tdorssers/meArm/schematic/meArm.sch

## EAGLE design schematic/meArm.sch (2019-11-09)

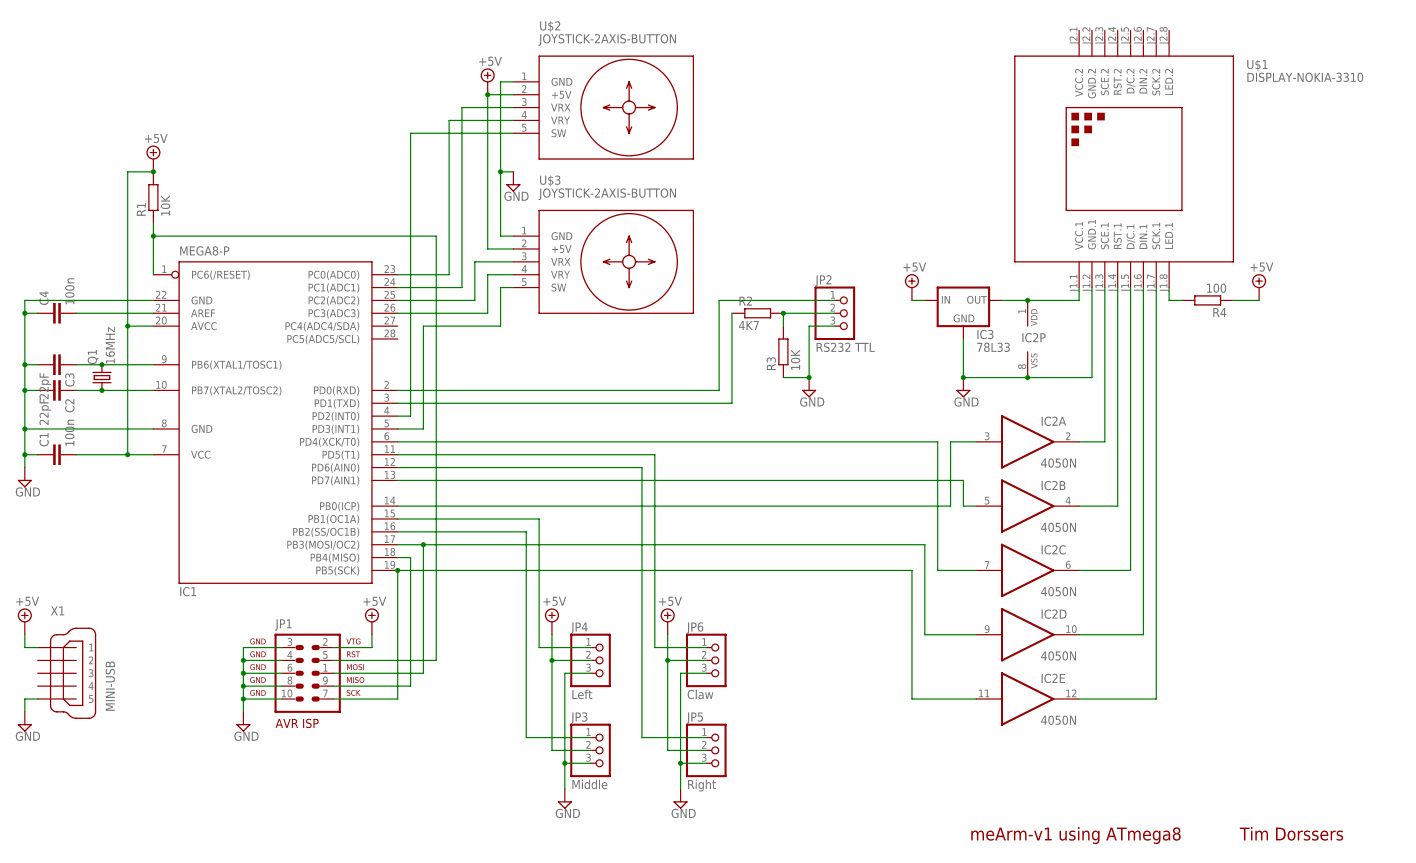
[picture p3: schematic meArm.sch]

Parts:
C1, C4: 100n; C025-025X050
C2, C3: 22pF; C025-024X044
IC1: MEGA8-P; DIL28-3
IC2: 4050N; DIL16
IC3: 78L33; 78LXX
JP1: AVR-ISP-10
JP2: RS232 TTL; 1X03
JP3: Middle; 1X03
JP4: Left; 1X03
JP5: Right; 1X03
JP6: Claw; 1X03
Q1: 16MHz; HC49U-V
R1, R3: 10K; 0204/7
R2: 4K7; 0204/7
R4: 100; 0204/7
U$1: DISPLAY-NOKIA-3310
U$2, U$3: JOYSTICK-2AXIS-BUTTON
X1: MINI-USB; 32005-601

Connections:
+5V: C1.2, IC1.7 (VCC), IC1.20 (AVCC), IC3.IN, JP1.2, JP3.2, JP4.2, JP5.2, JP6.2, R1.2, R4.1, U$2.2 (+5V), U$3.2 (+5V), X1.1
GND: C1.1, C2.2, C3.2, C4.1, IC1.8 (GND), IC1.22 (GND), IC2.8 (VSS), IC3.GND, JP1.3, JP1.4, JP1.6, JP1.8, JP1.10, JP2.3, JP3.3, JP4.3, JP5.3, JP6.3, R3.1, U$1.J1.2 (GND.1), U$2.1 (GND), U$3.1 (GND), X1.5
unnamed: IC1.19 (PB5(SCK)), IC2.11 (I), JP1.7
unnamed: IC2.1 (VDD), IC3.OUT, U$1.J1.1 (VCC.1)
unnamed: IC1.18 (PB4(MISO)), JP1.9
unnamed: IC1.17 (PB3(MOSI/OC2)), IC2.9 (I), JP1.1
unnamed: R4.2, U$1.J1.8 (LED.1)
unnamed: IC2.2 (O), U$1.J1.3 (SCE.1)
unnamed: IC2.4 (O), U$1.J1.4 (RST.1)
unnamed: IC2.6 (O), U$1.J1.5 (D/C.1)
unnamed: IC2.10 (O), U$1.J1.6 (DIN.1)
unnamed: IC2.12 (O), U$1.J1.7 (SCK.1)
unnamed: IC1.23 (PC0(ADC0)), U$2.4 (VRY)
unnamed: IC1.24 (PC1(ADC1)), U$2.3 (VRX)
unnamed: IC1.25 (PC2(ADC2)), U$3.3 (VRX)
unnamed: IC1.26 (PC3(ADC3)), U$3.4 (VRY)
unnamed: IC1.2 (PD0(RXD)), JP2.1
unnamed: IC1.3 (PD1(TXD)), R2.1
unnamed: IC1.4 (PD2(INT0)), U$2.5 (SW)
unnamed: IC1.5 (PD3(INT1)), U$3.5 (SW)
unnamed: IC1.1 (PC6(/RESET)), JP1.5, R1.1
unnamed: C3.1, IC1.9 (PB6(XTAL1/TOSC1)), Q1.2
unnamed: C2.1, IC1.10 (PB7(XTAL2/TOSC2)), Q1.1
unnamed: C4.2, IC1.21 (AREF)
unnamed: IC1.6 (PD4(XCK/T0)), IC2.7 (I)
unnamed: IC1.13 (PD7(AIN1)), IC2.5 (I)
unnamed: IC1.15 (PB1(OC1A)), JP4.1
unnamed: IC1.16 (PB2(SS/OC1B)), JP3.1
unnamed: IC1.14 (PB0(ICP)), IC2.3 (I)
unnamed: IC1.11 (PD5(T1)), JP6.1
unnamed: IC1.12 (PD6(AIN0)), JP5.1
unnamed: JP2.2, R2.2, R3.2

Notes on the sheet:
Tim Dorssers
meArm-v1 using ATmega8
