tdorssers/meArm/pcd8544.c

/*
 * pcd8544.c
 * 48x84 LCD Driver
 *
 * Created: 6-11-2019 18:05:15
 *  Author: Tim Dorssers
 *
 * Wiring:
 * PB2 -> SCE
 * PB3 -> DIN
 * PB5 -> CLK
 * PD4 -> D/C
 * PD7 -> RST
 */ 

#define F_CPU 16000000

#include <avr/io.h>
#include <util/delay.h>
#include <avr/pgmspace.h>
#include <string.h>

const uint8_t CHARSET[][5] PROGMEM = {
	{ 0x00, 0x00, 0x00, 0x00, 0x00 }, // 20 space
	{ 0x00, 0x00, 0x5f, 0x00, 0x00 }, // 21 !
	{ 0x00, 0x07, 0x00, 0x07, 0x00 }, // 22 "
	{ 0x14, 0x7f, 0x14, 0x7f, 0x14 }, // 23 #
	{ 0x24, 0x2a, 0x7f, 0x2a, 0x12 }, // 24 $
	{ 0x23, 0x13, 0x08, 0x64, 0x62 }, // 25 %
	{ 0x36, 0x49, 0x55, 0x22, 0x50 }, // 26 &
	{ 0x00, 0x05, 0x03, 0x00, 0x00 }, // 27 '
	{ 0x00, 0x1c, 0x22, 0x41, 0x00 }, // 28 (
	{ 0x00, 0x41, 0x22, 0x1c, 0x00 }, // 29 )
	{ 0x14, 0x08, 0x3e, 0x08, 0x14 }, // 2a *
	{ 0x08, 0x08, 0x3e, 0x08, 0x08 }, // 2b +
	{ 0x00, 0x50, 0x30, 0x00, 0x00 }, // 2c ,
	{ 0x08, 0x08, 0x08, 0x08, 0x08 }, // 2d -
	{ 0x00, 0x60, 0x60, 0x00, 0x00 }, // 2e .
	{ 0x20, 0x10, 0x08, 0x04, 0x02 }, // 2f /
	{ 0x3e, 0x51, 0x49, 0x45, 0x3e }, // 30 0
	{ 0x00, 0x42, 0x7f, 0x40, 0x00 }, // 31 1
	{ 0x42, 0x61, 0x51, 0x49, 0x46 }, // 32 2
	{ 0x21, 0x41, 0x45, 0x4b, 0x31 }, // 33 3
	{ 0x18, 0x14, 0x12, 0x7f, 0x10 }, // 34 4
	{ 0x27, 0x45, 0x45, 0x45, 0x39 }, // 35 5
	{ 0x3c, 0x4a, 0x49, 0x49, 0x30 }, // 36 6
	{ 0x01, 0x71, 0x09, 0x05, 0x03 }, // 37 7
	{ 0x36, 0x49, 0x49, 0x49, 0x36 }, // 38 8
	{ 0x06, 0x49, 0x49, 0x29, 0x1e }, // 39 9
	{ 0x00, 0x36, 0x36, 0x00, 0x00 }, // 3a :
	{ 0x00, 0x56, 0x36, 0x00, 0x00 }, // 3b ;
	{ 0x08, 0x14, 0x22, 0x41, 0x00 }, // 3c <
	{ 0x14, 0x14, 0x14, 0x14, 0x14 }, // 3d =
	{ 0x00, 0x41, 0x22, 0x14, 0x08 }, // 3e >
	{ 0x02, 0x01, 0x51, 0x09, 0x06 }, // 3f ?
	{ 0x32, 0x49, 0x79, 0x41, 0x3e }, // 40 @
	{ 0x7e, 0x11, 0x11, 0x11, 0x7e }, // 41 A
	{ 0x7f, 0x49, 0x49, 0x49, 0x36 }, // 42 B
	{ 0x3e, 0x41, 0x41, 0x41, 0x22 }, // 43 C
	{ 0x7f, 0x41, 0x41, 0x22, 0x1c }, // 44 D
	{ 0x7f, 0x49, 0x49, 0x49, 0x41 }, // 45 E
	{ 0x7f, 0x09, 0x09, 0x09, 0x01 }, // 46 F
	{ 0x3e, 0x41, 0x49, 0x49, 0x7a }, // 47 G
	{ 0x7f, 0x08, 0x08, 0x08, 0x7f }, // 48 H
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
	{ 0x02, 0x04, 0x08, 0x10, 0x20 }, // 5c backslash
	{ 0x00, 0x41, 0x41, 0x7f, 0x00 }, // 5d ]
	{ 0x04, 0x02, 0x01, 0x02, 0x04 }, // 5e ^
	{ 0x40, 0x40, 0x40, 0x40, 0x40 }, // 5f _
	{ 0x00, 0x01, 0x02, 0x04, 0x00 }, // 60 `
	{ 0x20, 0x54, 0x54, 0x54, 0x78 }, // 61 a
	{ 0x7f, 0x48, 0x44, 0x44, 0x38 }, // 62 b
	{ 0x38, 0x44, 0x44, 0x44, 0x20 }, // 63 c
	{ 0x38, 0x44, 0x44, 0x48, 0x7f }, // 64 d
	{ 0x38, 0x54, 0x54, 0x54, 0x18 }, // 65 e
	{ 0x08, 0x7e, 0x09, 0x01, 0x02 }, // 66 f
	{ 0x0c, 0x52, 0x52, 0x52, 0x3e }, // 67 g
	{ 0x7f, 0x08, 0x04, 0x04, 0x78 }, // 68 h
	{ 0x00, 0x44, 0x7d, 0x40, 0x00 }, // 69 i
	{ 0x20, 0x40, 0x44, 0x3d, 0x00 }, // 6a j
	{ 0x7f, 0x10, 0x28, 0x44, 0x00 }, // 6b k
	{ 0x00, 0x41, 0x7f, 0x40, 0x00 }, // 6c l
	{ 0x7c, 0x04, 0x18, 0x04, 0x78 }, // 6d m
	{ 0x7c, 0x08, 0x04, 0x04, 0x78 }, // 6e n
	{ 0x38, 0x44, 0x44, 0x44, 0x38 }, // 6f o
	{ 0x7c, 0x14, 0x14, 0x14, 0x08 }, // 70 p
	{ 0x08, 0x14, 0x14, 0x18, 0x7c }, // 71 q
	{ 0x7c, 0x08, 0x04, 0x04, 0x08 }, // 72 r
	{ 0x48, 0x54, 0x54, 0x54, 0x20 }, // 73 s
	{ 0x04, 0x3f, 0x44, 0x40, 0x20 }, // 74 t
	{ 0x3c, 0x40, 0x40, 0x20, 0x7c }, // 75 u
	{ 0x1c, 0x20, 0x40, 0x20, 0x1c }, // 76 v
	{ 0x3c, 0x40, 0x30, 0x40, 0x3c }, // 77 w
	{ 0x44, 0x28, 0x10, 0x28, 0x44 }, // 78 x
	{ 0x0c, 0x50, 0x50, 0x50, 0x3c }, // 79 y
	{ 0x44, 0x64, 0x54, 0x4c, 0x44 }, // 7a z
	{ 0x00, 0x08, 0x36, 0x41, 0x00 }, // 7b {
	{ 0x00, 0x00, 0x7f, 0x00, 0x00 }, // 7c |
	{ 0x00, 0x41, 0x36, 0x08, 0x00 }, // 7d }
	{ 0x10, 0x08, 0x08, 0x10, 0x08 }, // 7e ~
	{ 0x00, 0x00, 0x00, 0x00, 0x00 } // 7f
};

/* screen byte massive */
uint8_t screen[504];

/* cursor position */
uint8_t cursor_x;
uint8_t cursor_y;

static void write_cmd(uint8_t cmd) {
	PORTB &= ~(1 << PB2);  // CE chip enable - active low
	PORTD &= ~(1 << PD4);  // DC command (active low)
	// transmitting data
	SPDR = cmd;
	// wait till data transmit
	while (!(SPSR & (1 << SPIF)));
	PORTB |= (1 << PB2);   // CE chip disable - idle high
}

static void write_data(uint8_t data) {
	PORTB &= ~(1 << PB2);  // chip enable - active low
	PORTD |= 1 << PD4;     // data (active high)
	// transmitting data
	SPDR = data;
	// wait till data transmit
	while (!(SPSR & (1 << SPIF)));
	PORTB |= (1 << PB2);   // chip disable - idle high
}

void pcd8544_init(void) {
	/* Set pins as output */
	DDRB |= (1 << PB2); // SCE
	DDRB |= (1 << PB3); // DIN
	DDRB |= (1 << PB5); // CLK
	DDRD |= (1 << PD4); // D/C
	DDRD |= (1 << PD7); // RST

	// SPE  - SPI Enable
	// MSTR - Master device
	// SPR0 - Prescaler 16
	SPCR |= (1 << SPE) | (1 << MSTR) | (1 << SPR0);

	/* Reset display */
	PORTD |= (1 << PD7);  // reset high
	PORTB |= (1 << PB2);  // chip enable high
	_delay_ms(1);
	PORTD &= ~(1 << PD7); // reset low
	_delay_ms(1);
	PORTD |= (1 << PD7);  // reset high

	PORTB &= ~(1 << PB2);  /* Enable controller */
	write_cmd(0x21);  /* -LCD Extended Commands mode- */
	write_cmd(0x13);  /* LCD bias mode 1:48 */
	write_cmd(0x06);  /* Set temperature coefficient */
	write_cmd(0xC2);  /* Default VOP (3.06 + 66 * 0.06 = 7V) */
	write_cmd(0x20);  /* Standard Commands mode, Horizontal addressing mode */
	write_cmd(0x0C);  /* LCD in normal mode */
}

void pcd8544_clear(void) {
	cursor_x = 0;
	cursor_y = 0;
	memset(screen, 0, sizeof(screen));
}

void pcd8544_power(uint8_t on) {
	write_cmd(on ? 0x20 : 0x24);
}

void pcd8544_set_pixel(uint8_t x, uint8_t y, uint8_t value) {
	uint8_t *byte = &screen[y / 8 * 84 + x];
	uint8_t bit = (1 << (y % 8));
	if (value)
		*byte |= bit;
	else
		*byte &= ~bit;
}

void pcd8544_write_char(char code, uint8_t scale) {
	uint8_t x, y = 0;
	for (x = 0; x < 5 * scale; x++)
		for (y = 0; y < 7 * scale; y++)
			pcd8544_set_pixel(cursor_x + x, cursor_y + y, pgm_read_byte(&CHARSET[code - 32][x / scale]) & (1 << y / scale));

	cursor_x += x + 1;
	if (cursor_x >= 84) {
		cursor_x = 0;
		cursor_y += y + 1;
	}
	if (cursor_y >= 48) {
		cursor_x = 0;
		cursor_y = 0;
	}
}

void pcd8544_write_string(char *str, uint8_t scale) {
	while(*str)
		pcd8544_write_char(*str++, scale);
}

void pcd8544_write_string_p(const char *str, uint8_t scale) {
	char c;
	while ((c = pgm_read_byte(str++)))
		pcd8544_write_char(c, scale);
}

void pcd8544_set_cursor(uint8_t x, uint8_t y) {
	cursor_x = x;
	cursor_y = y;
}

void pcd8544_render(void) {
	/* Set column and row to 0 */
	write_cmd(0x80);
	write_cmd(0x40);
	/* Write screen to display */
	for (uint16_t i = 0; i < sizeof(screen); i++)
		write_data(screen[i]);
}

void pcd8544_draw_hline(uint8_t x, uint8_t y, uint8_t length) {
	do {
		pcd8544_set_pixel(x++, y, 1);
	} while(--length);
}

void pcd8544_draw_vline(uint8_t x, uint8_t y, uint8_t length) {
	do {
		pcd8544_set_pixel(x, y++, 1);
	} while(--length);
}

void pcd8544_draw_line(uint8_t x1, uint8_t y1, uint8_t x2, uint8_t y2) {
	int8_t D;  // determinant
	int8_t trace_x = 1, trace_y = 1;  // steps
	// deltas
	int8_t delta_x = x2 - x1;
	int8_t delta_y = y2 - y1;
	// check if x2 > x1
	if (delta_x < 0) {
		delta_x = -delta_x;  // negate delta x
		trace_x = -trace_x;  // negate step x
	}
	// check if y2 > y1
	if (delta_y < 0) {
		delta_y = -delta_y;  // negate delta y
		trace_y = -trace_y;  // negate step y
	}
	// Bresenham condition for m < 1 (dy < dx)
	if (delta_y < delta_x) {
		// calculate determinant
		D = 2 * delta_y - delta_x;
		// draw first pixel
		pcd8544_set_pixel(x1, y1, 1);
		// check if x1 equal x2
		while (x1 != x2) {
			// update x1
			x1 += trace_x;
			// check if determinant is positive
			if (D >= 0) {
				y1 += trace_y;  // update y1
				D -= 2 * delta_x;  // update determinant
			}
			// update determinant
			D += 2 * delta_y;
			// draw next pixel
			pcd8544_set_pixel(x1, y1, 1);
		}
	// for m > 1 (dy > dx)
	} else {
		// calculate determinant
		D = delta_y - 2 * delta_x;
		// draw first pixel
		pcd8544_set_pixel(x1, y1, 1);
		// check if y2 equal y1
		while (y1 != y2) {
			// update y1
			y1 += trace_y;
			// check if determinant is positive
			if (D <= 0) {
				x1 += trace_x;  // update x1
				D += 2 * delta_y;  // update determinant
			}
			// update determinant
			D -= 2 * delta_x;
			// draw next pixel
			pcd8544_set_pixel(x1, y1, 1);
		}
	}
}
